JaponXL/Loki65/kicad_files/loki65.kicad_sch

## KiCad design kicad_files/loki65.kicad_sch (2021-10-16)

Schematic: loki65.kicad_sch

Parts:
C1, C2, C8, C18, C19, C20, C21, C22, C23, C24, C25, C26, C27, C28, C29, C30, C31, C32, C33, C34, C35, C36, C37, C38, C39, C40, C41, C42, C43: 100n; C_0805_2012Metric
C3, C4, C5, C6, C15: 100n; C_0402_1005Metric
C7, C17: 4.7u; C_0402_1005Metric
C9: 1u; C_0402_1005Metric
C10: 10n; C_0402_1005Metric
C11, C12: 1u; CP_EIA-3216-10_Kemet-I_Pad1.58x1.35mm_HandSolder
C13, C14: 16p; C_0402_1005Metric
C16: 2.2u; C_0402_1005Metric
D1: RB060M-60TR; D_SOD-123; Manufacturer Part Number RB060M-60TR
D2, D3, D4, D5, D6, D7, D8, D9, D10, D11, D12, D13, D14, D15, D16, D17, D18, D19, D20, D21, D22, D23, D24, D25, D26, D27, D28, D29, D30, D31, D32, D33, D34, D35, D36, D37, D38, D39, D40, D41, D42, D43, D44, D45, D46, D47, D48, D49, D50, D51, D52, D53, D54, D55, D56, D57, D58, D59, D60, D61, D62, D63, D64, D65, D66, D67, D68, D69, D70: 1N4148W; D_SOD-123; Manufacturer Part Number 1N4148W
D71, D72, D73, D74, D75, D76, D77, D78, D79, D80, D81, D82, D83, D84, D85, D86, D87, D88, D89, D90, D91, D92, D93, D94, D95, D96: WS2812C-2020; LED_WS2812_2020; Manufacturer Part Number WS2812C-2020
F1: mSMD110-16V; Fuse_1812_4532Metric; Manufacturer Part Number mSMD110-16V
FB1: CBW201209U121T; L_0805_2012Metric; Manufacturer Part Number CBW201209U121T
GR1: Gondo Logo; gondolindrim_circuit-tree_10.4x12
GR2: Loki Helmet Logo; loki-helmet_18x10mm_plated
GR3: Lok65 label; loki65_label
J1: TYPE-C-31-M-12; Manufacturer Part Number TYPE-C-31-M-12
LED1, LED2: LED; LED_THT_2.54mm
R1, R2, R6: 1.5k; R_0402_1005Metric
R3, R4, R5: 10k; R_0805_2012Metric
R7: 100R; R_0805_2012Metric
R8: 0R; R_0805_2012Metric
R9, R10: 100k; R_0805_2012Metric
R11: 1k; R_0805_2012Metric
R12, R13: 5.1k; R_0805_2012Metric
R14, R15, R16, R17, R18, R19, R20, R21, R22, R23, R24, R25, R26, R27, R28, R29, R30, R31, R32, R33, R34, R35, R36, R37, R38, R39: 3R; R_0805_2012Metric
SW1: SSAL220100; Manufacturer Part Number SSAL220100
SW2: K2-1187SQ-A4SW-06; Manufacturer Part Number K2-1187SQ-A4SW-06
SW3, SW4, SW5, SW6, SW7, SW8, SW9, SW10, SW11, SW12, SW13, SW14, SW15, SW16, SW17, SW20, SW21, SW22, SW23, SW24, SW25, SW26, SW27, SW28, SW29, SW30, SW31, SW33, SW35, SW36, SW37, SW38, SW39, SW40, SW41, SW42, SW43, SW44, SW45, SW46, SW48, SW52, SW53, SW54, SW55, SW56, SW57, SW58, SW59, SW60, SW61, SW62, SW64, SW65, SW73, SW74, SW75, SW77: MX style mechanical keyboard switch; MX100
SW18: MX style mechanical keyboard switch; MX200
SW19, SW32, SW76, SW78, SW80: MX style mechanical keyboard switch; MX150
SW34, SW63: MX style mechanical keyboard switch; MX175
SW47: MX style mechanical keyboard switch; MX225R
SW49, SW66, SW67, SW68, SW69, SW71, SW72: MX style mechanical keyboard switch; MX125
SW50: MX style mechanical keyboard switch; MX_ISOEnter
SW51: MX style mechanical keyboard switch; MX225
SW70: MX style mechanical keyboard switch; MX625R
SW79: MX style mechanical keyboard switch; MX700R
U1: TXS0101DBVR; SOT-23-6; Manufacturer Part Number TXS0101DBVR
U2: BL24C256A-SFRC; TSSOP-8_4.4x3mm_P0.65mm; Manufacturer Part Number BL24C256A-SFRC
U3: STM32F411CEU6; STM_UFQFPN-48_LQFP-48-1EP_7x7mm_P0.5mm_HandSoldering_Therma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; Manufacturer Part Number STM32F411CEU6
U4: MCP1700T-3302E/TT; SOT-23; Manufacturer Part Number MCP1700T-3302E/TT
U5: USBLC6-2SC6; SOT-23-6; Manufacturer Part Number USBLC6-2SC6
X1: ARM JTAG; PinHeader_2x5_P2.54mm_Vertical_Staggered
X2: EXTRA_PINS; PinHeader_1x10_P2.54mm_Vertical
Y1: 7325-0800A2010-00; Crystal_SMD_3225-4Pin_3.2x2.5mm; Manufacturer Part Number 7325-0800A2010-00

Connections:
3V3: C1.2, C3.2, C4.1, C5.1, C6.2, C7.2, C9.1, C10.1, C12.1, C15.2, C17.2, D1.2 (A), R1.1, R2.1, R3.1, R6.1, R10.1, SW1.3 (C), U1.1 (VCCA), U2.8 (VCC), U3.1 (VBAT), U3.9 (VDDA/VREF+), U3.24 (VDD), U3.36 (VDD), U3.48 (VDD), U4.2 (VO), X1.7, X1.8, X2.1
5V: C2.1, C11.1, D1.1 (K), F1.2, LED1.A, LED2.A, R8.1, R9.1, R14.2, R15.2, R16.2, R17.2, R18.2, R19.2, R20.2, R21.2, R22.2, R23.2, R24.2, R25.2, R26.2, R27.2, R28.2, R29.2, R30.2, R31.2, R32.2, R33.2, R34.2, R35.2, R36.2, R37.2, R38.2, R39.2, U1.6 (VCCB), U4.3 (VI)
BOOT0: R4.1, U3.44 (BOOT0), X1.5
C0: SW3.2, SW19.2, SW34.2, SW49.1, SW51.1, SW66.1, SW67.2, SW76.2, U3.27 (PB14)
C1: SW4.1, SW20.1, SW35.1, SW52.2, SW68.1, SW77.1
C2: SW5.1, SW21.1, SW36.1, SW53.2, SW69.1, SW78.1
C3: SW6.1, SW22.1, SW37.1, SW54.1, U3.25 (PB12)
C4: SW7.1, SW23.1, SW38.1, SW55.1, U3.29 (PA8)
C5: SW8.1, SW24.1, SW39.1, SW56.2, U3.38 (PA15)
C6: SW9.1, SW25.1, SW40.2, SW57.1, SW70.1, SW79.2, U3.10 (PA0-WKUP)
C7: SW10.1, SW26.2, SW41.1, SW58.1, U3.39 (PB3)
C8: SW11.2, SW27.2, SW42.1, SW59.1, U3.40 (PB4)
C9: SW12.1, SW28.1, SW43.1, SW60.1, U3.41 (PB5)
C10: SW13.1, SW29.1, SW44.1, SW61.1, SW71.1, U3.45 (PB8)
C11: SW14.1, SW30.1, SW45.1, SW62.1, SW72.1, SW80.1, U3.46 (PB9)
C12: SW15.1, SW31.1, SW46.1, SW63.1, SW73.2, U3.2 (PC13)
C13: SW16.1, SW18.1, SW32.1, SW47.1, SW50.1, SW64.1, SW74.1, U3.3 (PC14_OSC32IN)
C14: SW17.1, SW33.1, SW48.1, SW65.1, SW75.1, U3.4 (PC15_OSC32OUT)
CAPS_INDICATOR: R11.2, U3.12 (PA2)
D+: R6.2, U3.33 (PA12), U5.1 (I/O1)
D-: U3.32 (PA11), U5.3 (I/O2)
DBUS+: J1.A6 (D+), J1.B6 (D+), U5.6 (I/O1)
DBUS-: J1.A7 (D-), J1.B7 (D-), U5.4 (I/O2)
GND: C1.1, C2.2, C3.1, C4.2, C5.2, C6.1, C7.1, C8.2, C9.2, C10.2, C11.2, C12.2, C13.2, C14.2, C15.1, C16.1, C17.1, C18.2, C19.2, C20.2, C21.2, C22.2, C23.2, C24.2, C25.2, C26.2, C27.2, C28.2, C29.2, C30.2, C31.2, C32.2, C33.2, C34.2, C35.2, C36.2, C37.2, C38.2, C39.2, C40.2, C41.2, C42.2, C43.2, D71.2 (VSS), D72.2 (VSS), D73.2 (VSS), D74.2 (VSS), D75.2 (VSS), D76.2 (VSS), D77.2 (VSS), D78.2 (VSS), D79.2 (VSS), D80.2 (VSS), D81.2 (VSS), D82.2 (VSS), D83.2 (VSS), D84.2 (VSS), D85.2 (VSS), D86.2 (VSS), D87.2 (VSS), D88.2 (VSS), D89.2 (VSS), D90.2 (VSS), D91.2 (VSS), D92.2 (VSS), D93.2 (VSS), D94.2 (VSS), D95.2 (VSS), D96.2 (VSS), FB1.1, J1.A1 (GND), J1.B1 (GND), R5.1, R9.2, R10.2, R12.1, R13.1, SW1.1 (A), SW2.1 (A), U1.2 (GND), U2.1 (A0), U2.2 (A1), U2.3 (A2), U2.4 (GND), U2.7 (WP), U3.8 (VSSA), U3.23 (VSS), U3.35 (VSS), U3.47 (VSS), U4.1 (GND), U5.2 (GND), X1.3, X1.4, X1.10, X2.10, Y1.2, Y1.4
GNDPWR: FB1.2, J1.S (SHIELD)
NRST: C8.1, R7.2, U3.7 (NRST), X1.9
unnamed: C16.2, U3.22 (VCAP_1)
unnamed: C18.1, D71.4 (VDD), R14.1
unnamed: C19.1, D72.4 (VDD), R15.1
unnamed: C20.1, D73.4 (VDD), R16.1
unnamed: C21.1, D74.4 (VDD), R17.1
unnamed: C22.1, D75.4 (VDD), R18.1
unnamed: C23.1, D76.4 (VDD), R19.1
unnamed: C24.1, D77.4 (VDD), R20.1
unnamed: C25.1, D78.4 (VDD), R21.1
unnamed: C26.1, D79.4 (VDD), R22.1
unnamed: C27.1, D80.4 (VDD), R23.1
unnamed: C28.1, D81.4 (VDD), R24.1
unnamed: C29.1, D82.4 (VDD), R25.1
unnamed: C30.1, D83.4 (VDD), R26.1
unnamed: C31.1, D84.4 (VDD), R27.1
unnamed: C32.1, D85.4 (VDD), R28.1
unnamed: C33.1, D86.4 (VDD), R29.1
unnamed: C34.1, D87.4 (VDD), R30.1
unnamed: C35.1, D88.4 (VDD), R31.1
unnamed: C36.1, D89.4 (VDD), R32.1
unnamed: C37.1, D90.4 (VDD), R33.1
unnamed: C38.1, D91.4 (VDD), R34.1
unnamed: C39.1, D92.4 (VDD), R35.1
unnamed: C40.1, D93.4 (VDD), R36.1
unnamed: C41.1, D94.4 (VDD), R37.1
unnamed: C42.1, D95.4 (VDD), R38.1
unnamed: C43.1, D96.4 (VDD), R39.1
unnamed: D2.2 (A), SW3.1
unnamed: D3.2 (A), SW4.2
unnamed: D4.2 (A), SW5.2
unnamed: D5.2 (A), SW6.2
unnamed: D6.2 (A), SW7.2
unnamed: D7.2 (A), SW8.2
unnamed: D8.2 (A), SW9.2
unnamed: D9.2 (A), SW10.2
unnamed: D10.2 (A), SW11.1
unnamed: D11.2 (A), SW12.2
unnamed: D12.2 (A), SW13.2
unnamed: D13.2 (A), SW14.2
unnamed: D14.2 (A), SW15.2
unnamed: D15.2 (A), SW16.2, SW18.2
unnamed: D16.2 (A), SW17.2
unnamed: D17.2 (A), SW19.1
unnamed: D18.2 (A), SW20.2
unnamed: D19.2 (A), SW21.2
unnamed: D20.2 (A), SW22.2
unnamed: D21.2 (A), SW23.2
unnamed: D22.2 (A), SW24.2
unnamed: D23.2 (A), SW25.2
unnamed: D24.2 (A), SW26.1
unnamed: D25.2 (A), SW27.1
unnamed: D26.2 (A), SW28.2
unnamed: D27.2 (A), SW29.2
unnamed: D28.2 (A), SW30.2
unnamed: D29.2 (A), SW31.2
unnamed: D30.2 (A), SW32.2
unnamed: D31.2 (A), SW33.2
unnamed: D32.2 (A), SW34.1, SW49.2
unnamed: D33.2 (A), SW35.2
unnamed: D34.2 (A), SW36.2
unnamed: D35.2 (A), SW37.2
unnamed: D36.2 (A), SW38.2
unnamed: D37.2 (A), SW39.2
unnamed: D38.2 (A), SW40.1
unnamed: D39.2 (A), SW41.2
unnamed: D40.2 (A), SW42.2
unnamed: D41.2 (A), SW43.2
unnamed: D42.2 (A), SW44.2
unnamed: D43.2 (A), SW45.2
unnamed: D44.2 (A), SW46.2
unnamed: D45.2 (A), SW47.2, SW50.2
unnamed: D46.2 (A), SW48.2
unnamed: D47.2 (A), SW51.2, SW66.2
unnamed: D48.2 (A), SW52.1
unnamed: D49.2 (A), SW53.1
unnamed: D50.2 (A), SW54.2
unnamed: D51.2 (A), SW55.2
unnamed: D52.2 (A), SW56.1
unnamed: D53.2 (A), SW57.2
unnamed: D54.2 (A), SW58.2
unnamed: D55.2 (A), SW59.2
unnamed: D56.2 (A), SW60.2
unnamed: D57.2 (A), SW61.2
unnamed: D58.2 (A), SW62.2
unnamed: D59.2 (A), SW63.2
unnamed: D60.2 (A), SW64.2
unnamed: D61.2 (A), SW65.2
unnamed: D62.2 (A), SW67.1, SW76.1
unnamed: D63.2 (A), SW68.2, SW77.2
unnamed: D64.2 (A), SW69.2, SW78.2
unnamed: D65.2 (A), SW70.2, SW79.1
unnamed: D66.2 (A), SW71.2
unnamed: D67.2 (A), SW72.2, SW80.2
unnamed: D68.2 (A), SW73.1
unnamed: D69.2 (A), SW74.2
unnamed: D70.2 (A), SW75.2
unnamed: D71.1 (DOUT), D72.3 (DIN)
unnamed: D72.1 (DOUT), D73.3 (DIN)
unnamed: D73.1 (DOUT), D74.3 (DIN)
unnamed: D74.1 (DOUT), D75.3 (DIN)
unnamed: D75.1 (DOUT), D76.3 (DIN)
unnamed: D76.1 (DOUT), D77.3 (DIN)
unnamed: D77.1 (DOUT), D78.3 (DIN)
unnamed: D78.1 (DOUT), D79.3 (DIN)
unnamed: D79.1 (DOUT), D80.3 (DIN)
unnamed: D80.1 (DOUT), D81.3 (DIN)
unnamed: D81.1 (DOUT), D82.3 (DIN)
unnamed: D82.1 (DOUT), D83.3 (DIN)
unnamed: D83.1 (DOUT), D84.3 (DIN)
unnamed: D84.1 (DOUT), D85.3 (DIN)
unnamed: D85.1 (DOUT), D86.3 (DIN)
unnamed: D86.1 (DOUT), D87.3 (DIN)
unnamed: D87.1 (DOUT), D88.3 (DIN)
unnamed: D88.1 (DOUT), D89.3 (DIN)
unnamed: D89.1 (DOUT), D90.3 (DIN)
unnamed: D90.1 (DOUT), D91.3 (DIN)
unnamed: D91.1 (DOUT), D92.3 (DIN)
unnamed: D92.1 (DOUT), D93.3 (DIN)
unnamed: D93.1 (DOUT), D94.3 (DIN)
unnamed: D94.1 (DOUT), D95.3 (DIN)
unnamed: D95.1 (DOUT), D96.3 (DIN)
unnamed: J1.A5 (CC1), R12.2
unnamed: J1.B5 (CC2), R13.2
unnamed: LED1.K, LED2.K, R11.1
unnamed: R3.2, U1.5 (OE)
unnamed: R4.2, SW1.2 (B)
unnamed: R7.1, SW2.2 (B)
PA3: U3.13 (PA3), X2.3
PA4: U3.14 (PA4), X2.4
PA5: U3.15 (PA5), X2.5
PA6: U3.16 (PA6), X2.6
PA7: U3.17 (PA7), X2.7
PA9: R8.2, U3.30 (PA9)
PB0: U3.18 (PB0), X2.8
PB1: U3.19 (PB1), X2.9
PB2/BOOT1: R5.2, U3.20 (PB2), X1.6
PB13: U3.26 (PB13), X2.2
R0: D2.1 (K), D3.1 (K), D4.1 (K), D5.1 (K), D6.1 (K), D7.1 (K), D8.1 (K), D9.1 (K), D10.1 (K), D11.1 (K), D12.1 (K), D13.1 (K), D14.1 (K), D15.1 (K), D16.1 (K)
R1: D17.1 (K), D18.1 (K), D19.1 (K), D20.1 (K), D21.1 (K), D22.1 (K), D23.1 (K), D24.1 (K), D25.1 (K), D26.1 (K), D27.1 (K), D28.1 (K), D29.1 (K), D30.1 (K), D31.1 (K)
R2: D32.1 (K), D33.1 (K), D34.1 (K), D35.1 (K), D36.1 (K), D37.1 (K), D38.1 (K), D39.1 (K), D40.1 (K), D41.1 (K), D42.1 (K), D43.1 (K), D44.1 (K), D45.1 (K), D46.1 (K), U3.31 (PA10)
R3: D47.1 (K), D48.1 (K), D49.1 (K), D50.1 (K), D51.1 (K), D52.1 (K), D53.1 (K), D54.1 (K), D55.1 (K), D56.1 (K), D57.1 (K), D58.1 (K), D59.1 (K), D60.1 (K), D61.1 (K), U3.21 (B10)
R4: D62.1 (K), D63.1 (K), D64.1 (K), D65.1 (K), D66.1 (K), D67.1 (K), D68.1 (K), D69.1 (K), D70.1 (K), U3.11 (PA1)
RGB_3V3: U1.3 (A), U3.28 (PB15)
RGB_5V: D71.3 (DIN), U1.4 (B)
SCL: R2.2, U2.6 (SCL), U3.42 (PB6)
SDA: R1.2, U2.5 (SDA), U3.43 (PB7)
SWCLK: U3.37 (PA14), X1.2
SWDIO: U3.34 (PA13), X1.1
VBUS: F1.1, J1.A4 (VBUS), J1.B4 (VBUS), U5.5 (VBUS)
XTAL_IN: C14.1, U3.5 (PH0_OSCIN), Y1.3
XTAL_OUT: C13.1, U3.6 (PH1_OSCOUT), Y1.1

Notes on the sheet:
EEPROM
SWITCH MATRIX
(*) "Spooky pins": on STM32F4x1, pins A9 and B2 cannot be used for switch matrix: - A9 is meant to be used as a VBUS sensing. It has a undocumented internal pulldown resistor; - B2 is used as BOOT1 during bootup, so it needs an external pulldown for successful bootup
(**) PA9 jumper: a solderable jumper used to tie PA9 to VBUS. It is disconnected by default, hence PA9 is left floating
MCU
Spooky pin (*)
HARD RESET
USB CONNECTOR
GRAPHICS
USB ESD
3V3
RGB STRIP
