JaponXL/Loki65/(commit log)

2021-09-24 First version
    [loki65.kicad_sch]
2021-10-08 Logos, extra pins, routing
    - Loki65 logo added
    - Gondolindrim logo added
    - Extra remaining pins added
    - Finish routing
    - DRC pending
    [loki65.kicad_sch]
2021-10-16 Add label, run DRC, expose B13
    - Label for revision Alpha-rc1 added
    - Gondolindrim and Loki65 logos had soldermask clearance added to 0.5mm
    - DRC ran and errors corrected
    - Pin B13 exposed
    [loki65.kicad_sch]
2021-10-16 Remove double BOOT1 resistor, add metadata
    - Removed a double resistor grounding BOOT1
    - Edited component metadata
    - Release-ready
    [loki65.kicad_sch]
